MobileSensorPlatform/mobile-sensor-pcb/led-arc-multilayer.png

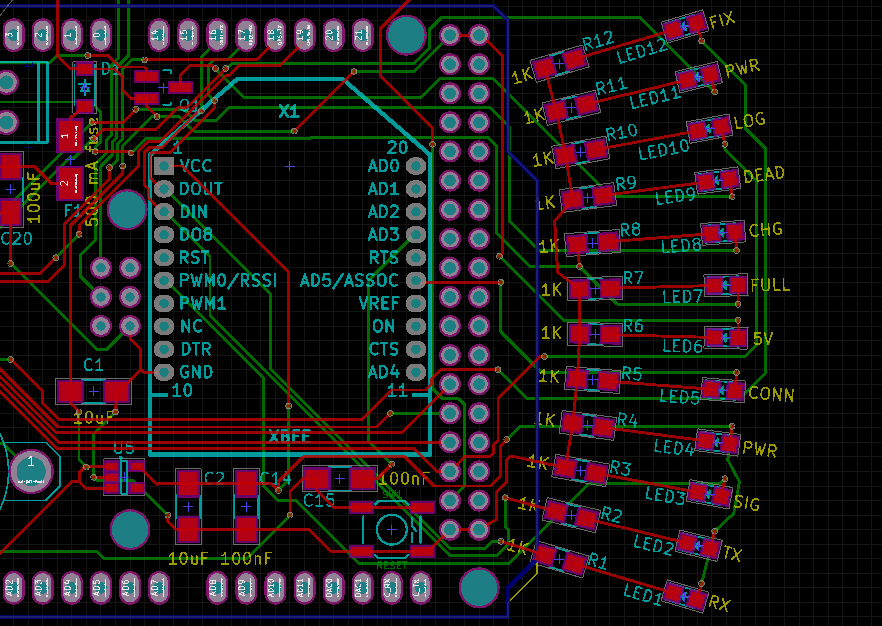
led-arc-multilayer.png
