MobileSensorPlatform/mobile-sensor-pcb/led-arc-top-layer.png

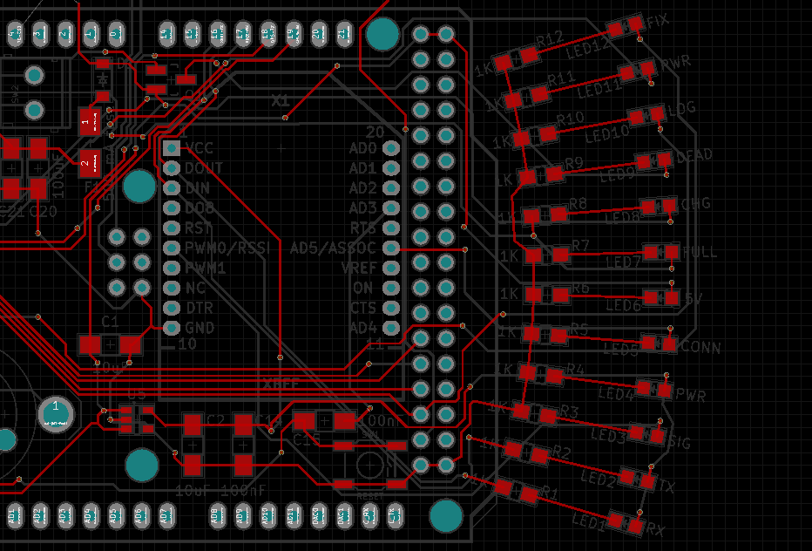
led-arc-top-layer.png
