MobileSensorPlatform/mobile-sensor-pcb/pcb-screenshot-2015-10-09.png

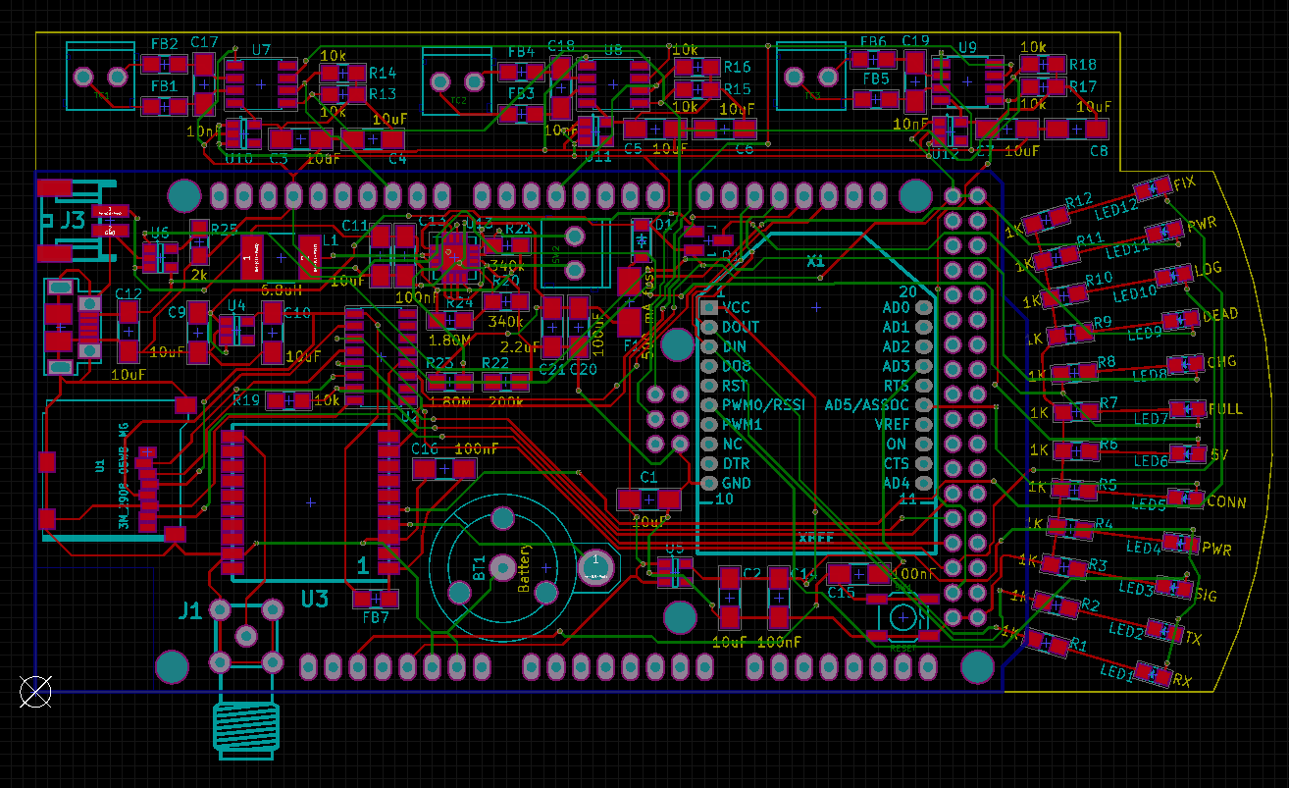
pcb-screenshot-2015-10-09.png
