MobileSensorPlatform/mobile-sensor-pcb/(commit log)

2015-09-07 Start BOM
    [mobile-sensor-bom.csv]
2015-09-07 Finish first cut at BOM
    [mobile-sensor-bom.csv]
2015-09-07 Add thermocouple amps and fix a few omissions
    [mobile-sensor-bom.csv]
2015-09-09 Update BOM details
    [mobile-sensor-bom.csv]
2015-09-09 First complete version of BOM
    [mobile-sensor-bom.csv]
2015-09-09 Add PCB footprints
    [mobile-sensor-bom.csv]
2015-09-10 Start PCB layout
    [mobile-sensor-pcb.kicad_pcb, mobile-sensor-pcb.sch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]
2015-09-11 Add more components and footprints
    [mobile-sensor-bom.csv, mobile-sensor-pcb.kicad_pcb, mobile-sensor-pcb.sch]
2015-09-17 More components added
    [mobile-sensor-pcb.sch]
2015-09-17 More components, plus update footprint library rev
    [mobile-sensor-pcb.kicad_pcb, mobile-sensor-pcb.sch]
2015-09-18 More components, more footprints
    [mobile-sensor-bom.csv, mobile-sensor-pcb.kicad_pcb, mobile-sensor-pcb.sch]
2015-09-21 First commit with all footprints added
    [mobile-sensor-pcb.kicad_pcb, mobile-sensor-pcb.sch]
2015-09-23 Start connecting stuff. Still need a few more resistors.
    [mobile-sensor-pcb.kicad_pcb, mobile-sensor-pcb.sch]
2015-09-24 Schematic done
    [mobile-sensor-pcb.kicad_pcb, mobile-sensor-pcb.sch]
2015-09-25 Fix a few bad connections, start to lay out PCB
    [mobile-sensor-pcb.kicad_pcb, mobile-sensor-pcb.sch]
2015-09-29 Arrange thermocouple amps
    [mobile-sensor-pcb.kicad_pcb]
2015-10-01 Add script for placing LEDs in an arc
2015-10-01 Tweak LED layout a little
    [mobile-sensor-pcb.kicad_pcb]
2015-10-02 More routing
    [mobile-sensor-pcb.kicad_pcb, mobile-sensor-pcb.sch]
2015-10-06 Route all but thermocouples. Add LED arc screenshots.
    [mobile-sensor-pcb.kicad_pcb, mobile-sensor-pcb.sch]
2015-10-08 Minor PCB fixes. Rework BOM to have fewer distributors. Change battery holder part.
    [mobile-sensor-bom.csv, mobile-sensor-pcb.kicad_pcb, mobile-sensor-pcb.sch]
2015-10-08 Remove power switch and reset headers. Split BOM into orders.
    [adafruit-2015-10-08.csv, digikey-2015-10-08.csv, itead-studio-2015-10-08.csv, mobile-sensor-bom.csv]
2015-11-04 Fix a R19 connection, spin SD card holder, fix SMA jack
    [mobile-sensor-pcb.kicad_pcb, mobile-sensor-pcb.sch]
2015-11-04 Update footprint submodule
2015-11-09 Lots of little tweaks, rounding corners, fixing designators, adding labels, name, date and rev
    [mobile-sensor-pcb.kicad_pcb]
2015-11-10 Create gerbers and release zipball
    [mobile-sensor-pcb-B_Cu.gbr, mobile-sensor-pcb-B_SilkS.gbr, mobile-sensor-pcb-Edge_Cuts.gbr, mobile-sensor-pcb-F_Cu.gbr, mobile-sensor-pcb-F_SilkS.gbr, mobile-sensor-pcb-NPTH.drl, mobile-sensor-pcb.drl]
2015-11-11 Generate forgotten soldermask layers
    [mobile-sensor-pcb.kicad_pcb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]
2015-12-10 Add BOMs and what appear to be some final PCB changes
    [adafruit-2015-10-08.csv, digikey-2015-10-08.csv, itead-studio-2015-10-08.csv, mobile-sensor-bom.csv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]
